gdampf/Smart-Dimmer/Schematic_New Smart Dimmer 3_2020-07-02_07-56-38.png

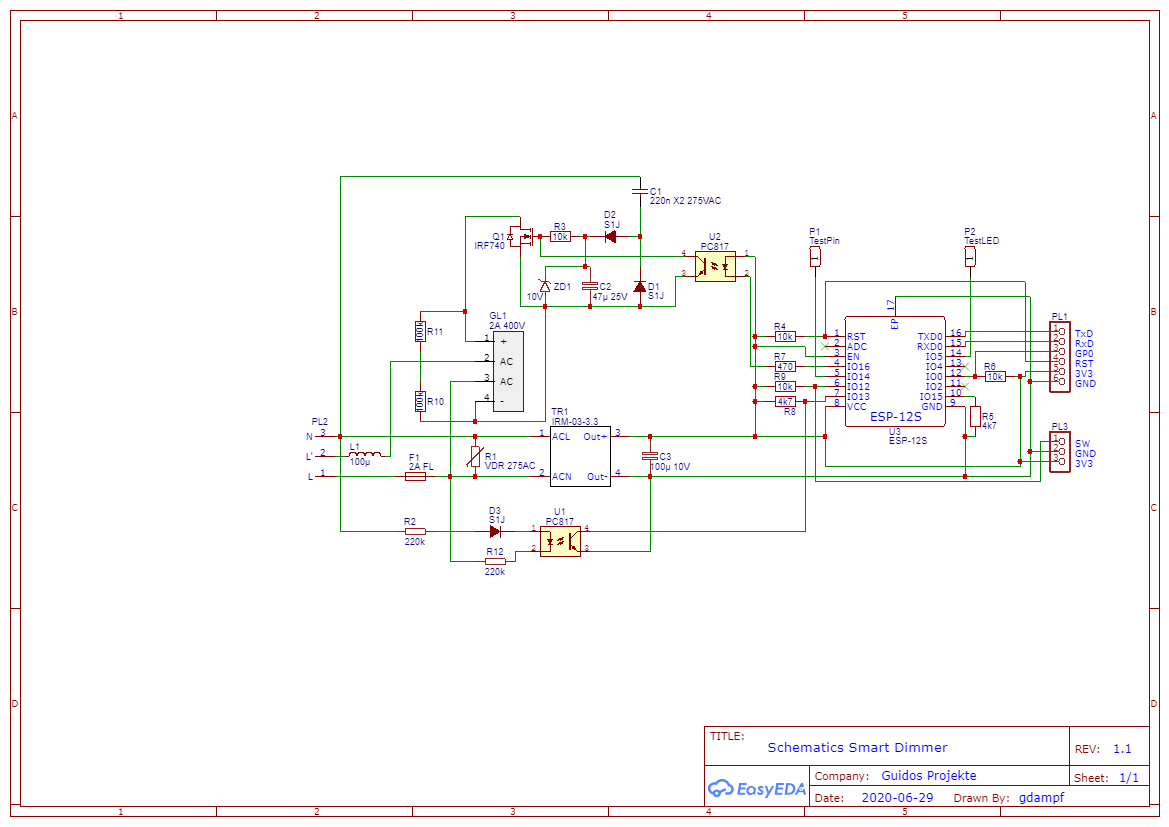
Schematic_New Smart Dimmer 3_2020-07-02_07-56-38.png
