gdampf/Smart-Dimmer/s_dimmer_mod_schematics.asc

C1: cap; 220n; V=360 Rser=1 Lser=1
C2: polcap; 47µ 25V; V=25 Irms=170m Rser=1 Lser=0 mfg="Nichicon" pn="UPG1E470MPH" type="Al electrolytic"
C3: cap; 100µ; V=10 Irms=0 Rser=0 Lser=0 mfg="Murata" pn="GRM31CR61A107ME05" type="X5R"
D1: diode; S1J
D2: diode; S1J
D3: diode; 1N4007
D4: diode; ""
D5: diode; ""
D6: diode; ""
D7: diode; ""
FS1: fuse2
L1: ind; 100 µH 2 A; Ipk=2
LP1: lamp; Verbraucher
Q1: irf740lc
R1: varistor; VDR 275VAC
R2: res; 220k; tol=5 pwr=0.125
R3: res; 10k; tol=5 pwr=0.125
R4: res; 10k
R5: res; 4700
R6: res; 10k
R7: res; 470
R8: res; 4700; tol=5 pwr=0.125
R9: res; 10k
R10: res; 100k
R11: res; 100k
R12: res; 220k
U1: PC817C
U2: PC817C
U3: transformer2; L1=1H L2=66H  K=1
U4: reg3all_; 3.3
U5: bridgerectifier
V2: voltage; SINE(0 230 50)
ZD1: zener; 10V
Named nets: opto, in, GPIO13, GPIO16, VCC, GND, SW, ENA, RST, GPIO12, GPIO15, GPIO0
.tran 0 1.04 1 0.001
GL1 2A 400V
TR1 AC_DC_MYRRA IRM-03
