gdampf/Smart-Dimmer/(commit log)

2020-06-02 Überarbeitung des Sketch und veränderte Schaltung
    Schaltung und Software überarbeitet.
    Eine Kombination aus dem ersten Entwurf des Autors (Herr Rohne) und der Heft-Schaltung aus Make läuft endlich zufriedenstellend - ideal mit einem PC815 als U2, aber auch mit dem PC817. Die Flanken des Sync-Signals sind dann zwar nicht so schön wie bei einem PC815, aber mit einer Software, die auf Timer und HW-Interrupts basiert, macht es nichts, wenn die eine oder andere Flanke nicht ganz genau ist.
    Leider muss man, wenn man die Heft-Platine nicht neu designen möchte, folgenden Eingriff vornehmen:
    1. D3 und R2 werden nicht bestückt und PIN 2 von U1 wird hoch gebogen und nicht mit der Platine verl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
2020-06-02 Anpassung BOM
2020-06-03 Reset Passwort auslagern
    Das (optionale) Paswort zum Resetten der Einstellungen wurde in eine Datei "secret.h" ausgelagert. Ist diese nicht vorhanden, wird kein Passwort verwendet.
    [dimmer3d.ino]
2020-07-04 Complete refactoring
    Zusätzlich: smooth on/off mit wählbaren Anfangswert beim Einschalten oder letztem benutzten Wert
    Wählbare Schrittweite increment/decrement über MQTT z.B. für Steuerung mit SmartWatch
    Bug-Fixing
    Saubere Nutzung des EEPROMS
    Zusammenfassung der relevanten Werte in Strukturen
    Entfernen überflüssigen Codes
    Programmierbarkeit per OTA
    [dimmer3d.ino]
2020-07-04 Update README.md
    Hinweis auf neues Layout und Sketch
2020-07-04 New Gerber
    Komplettes redesign der Schaltung ohne Störimpulsen auf dem Sync
